Twilight-qwq/Intelligent-tracking-car-based-on-STM32-and-K210/Visual/config.py

# -*- coding: utf-8 -*-
"""
============================================================
 config.py  ·  所有可以调的东西都在这一个文件里
------------------------------------------------------------
 这个文件里没有任何逻辑，全是数字和开关。调参只改这里。
============================================================
"""

# ------------------------------------------------------------
# 一、摄像头怎么装的（上车前必须量准）
# ------------------------------------------------------------
CAM_H_CM = 20.0             # 镜头离地高度，单位厘米
CAM_PITCH_DEG = 30.0        # 镜头往下低头多少度
HFOV_DEG = 90.0             # 镜头水平视场角

ROW_TWEAK = 0               # 整组扫描行上/下平移几行（应急微调）

N_SCAN = 5                  # 用几行扫描
GAP_MIN = 22                # 最远那行：黑线至少要占这么多像素
GAP_MAX = 62                # 最近那行：再近车道就撑出画面了


# ------------------------------------------------------------
# 二、找线
# ------------------------------------------------------------
RUN_MIN = 3                 # 连续几个黑点才算一条线（滤噪点）
RUN_MAX = 26                # 超过这么宽就不是"线"，是糊成一片
GAP_TOL = 14                # 实测间距和理论值差多少还算数
SIDE_DEAD = 12              # 只剩一根线时，它离画面中心多近就不敢判左右
CONTRAST_MIN = 70           # 这一行最亮减最暗至少多少才认
BLACK_RATIO = 0.40          # 阈值 = 最暗 + (最亮 - 最暗) * 0.40

X_MIN = 4                   # 每行从左扫到哪
X_MAX = 155                 # 每行扫到右到哪


# ------------------------------------------------------------
# 三、判断
# ------------------------------------------------------------
CALIB_OFFSET = 0            # 车摆正时读出多少就填多少
ERROR_GAIN = 1.0            # 误差再放大或缩小，一般不用改

CURV_T1 = 10                # 远处偏差 > 10 像素 -> 状态 1
CURV_T2 = 22                # 远处偏差 > 22 像素 -> 状态 2

CORNER_BIAS = 40            # 确认前面是右弯时，把误差顶到多少
CORNER_TRIGGER = 8          # 但只有当前误差还小于这个数才算"刚进弯"
CORNER_X = 50               # 外侧线在这个位置左边 = 前面是右弯

SMOOTH_SHIFT = 0            # 0 = 不滤波；画面抖就改 1 或 2

LOST_KEEP = 10              # 丢线 10 帧以内：照上次的结果继续发
LOST_ERR_HOLD = 1           # 超过 10 帧：1=沿用上次误差，0=发 0

FINISH_ENABLE = False       # 终点线检测，默认关
FINISH_ROWS = 4             # 几行整行变黑才算横线
FINISH_FRAMES = 3           # 连续几帧才认


# ------------------------------------------------------------
# 四、串口
# ------------------------------------------------------------
BAUD = 115200               # 必须和 STM32 一致
PIN_TX = 24                 # K210 IO24 -> STM32 PA10
PIN_RX = 25                 # 用不到，但 fpioa 要先占住


# ------------------------------------------------------------
# 五、调试
# ------------------------------------------------------------
VFLIP = False               # 画面上下颠倒改 True
HMIRROR = False             # 画面左右镜像改 True（误差自动取反）
DEBUG_DRAW = True           # 画面上画标记
PRINT_EVERY = 30            # 每 30 帧打印一行
PRINT_TABLE = True          # 启动时把算出来的表打出来
