Twilight-qwq/Intelligent-tracking-car-based-on-STM32-and-K210/Control/HardwareLayer/ReceiverK210.c

#include "stm32f10x.h"
#include "ReceiverK210.h"
#include "Protocol.h"
void k210rcv_Init(void)
{
	RCC_APB2PeriphClockCmd(RCC_APB2Periph_GPIOA,ENABLE);
	GPIO_InitTypeDef GPIO_InitStruct;
	GPIO_InitStruct.GPIO_Mode=GPIO_Mode_IPU;
	GPIO_InitStruct.GPIO_Pin=GPIO_Pin_10;
	GPIO_InitStruct.GPIO_Speed=GPIO_Speed_50MHz;
	GPIO_Init(GPIOA,&GPIO_InitStruct);

	RCC_APB2PeriphClockCmd(RCC_APB2Periph_USART1,ENABLE);
	USART_InitTypeDef USART_Initstruct;
	USART_Initstruct.USART_BaudRate=115200;
	USART_Initstruct.USART_HardwareFlowControl=USART_HardwareFlowControl_None;
	USART_Initstruct.USART_Mode=USART_Mode_Rx;
	USART_Initstruct.USART_Parity=USART_Parity_No;
	USART_Initstruct.USART_StopBits=USART_StopBits_1;
	USART_Initstruct.USART_WordLength=USART_WordLength_8b;
	USART_Init(USART1,&USART_Initstruct);
	USART_ITConfig(USART1,USART_IT_RXNE,ENABLE);

	NVIC_InitTypeDef NVIC_InitStruct;
	NVIC_InitStruct.NVIC_IRQChannel=USART1_IRQn;
	NVIC_InitStruct.NVIC_IRQChannelCmd=ENABLE;
	NVIC_InitStruct.NVIC_IRQChannelPreemptionPriority=0;
	NVIC_InitStruct.NVIC_IRQChannelSubPriority=0;
	NVIC_Init(&NVIC_InitStruct);

	USART_Cmd(USART1,ENABLE);
}

void USART1_IRQHandler(void)
{
	if(USART_GetITStatus(USART1,USART_IT_RXNE)==SET)
	{
		uint8_t data = USART_ReceiveData(USART1);
		Protocol_VisionParse(data);
	}
}
