Twilight-qwq/Intelligent-tracking-car-based-on-STM32-and-K210/(commit log)

2026-11-07 feat: STM32F103 + K210 dual-core line-following vehicle (control, vision, specification)
    [引脚分配表.xlsx]
2026-11-07 feat(debug): switch debug stream to VOFA+ JustFloat binary frames
    - 24-byte frame: five little-endian IEEE-754 floats plus the 0x00 0x00 0x80 0x7F tail
    - channels: left target / left actual / right target / right actual / vision error
    - removes the printf and %.1f dependency on MicroLIB entirely
    - Debug_log now takes a debugdata_t pointer and runs unconditionally, so frames
    keep flowing while the vehicle is stopped
    [Service.c]
2026-11-07 fix(service): sample the encoder before reading it in the 5 ms velocity loop
    Encoder_GetDeltaLeft/Right return the delta produced by the previous
    Encoder_Update() call. Reading them before calling Encoder_Update() therefore
    handed the velocity PI a one-period-stale measurement, adding avoidable phase
    lag to the inner loop.
    Also dropped an outdated comment block in Debug.c that no longer described the
    JustFloat frame layout.
    [Service.c]
2026-11-08 feat(protocol): struct-based parsers, Bluetooth tuning channel, runtime-tunable gains
    - protocol layer exposes VisionData_t / Protocol_GetVision and BtCommand_t /
    Protocol_BtParse instead of raw globals; ISR and caller contexts are separated
    by a PRIMASK save-restore critical section
    - USART2 gains a 32-byte RX ring buffer so the Bluetooth tuning path no longer
    blocks the main loop
    - tuning frames pass two validation layers: a NaN/Inf gate followed by
    per-parameter min/max limits
    - base speeds and PID gains are runtime variables, tunable from a phone without
    reflashing
    - the steering differential is clamped to the current base speed, keeping wheel
    targets non-negative and decoupl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
    [BlueTooth.c, ReceiverK210.c, Service.c, Service.h]
2026-11-08 chore(build): convert all sources to UTF-8 with BOM
    Every .c/.h under Control/ was GBK-encoded, which GitHub renders as mojibake
    because it decodes blobs as UTF-8. This converts them to UTF-8 with a BOM
    so both Keil and VS Code pick up the encoding without any manual step.
    - 21 files re-encoded; text was verified character-identical file by file.
    - Key.c was already UTF-8 but had no BOM, so six bytes were prepended.
    - Control/.vscode/settings.json now pins files.encoding to utf8 and turns
    files.autoGuessEncoding off, since that option silently overrode it.
    A full rebuild after the conversion produced an identical image
    (Code=8676 RO-data=272 RW-data=116 ZI-data=1172, 0 errors 0 warnings)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
    [BlueTooth.c, Encoder.c, Encoder.h, Key.c, Motor.c]
2026-11-08 feat(indicator): PC13 status LED driven by run state and vision health
    The board LED (PC13, active low) now reports what the car is doing, so the
    vehicle can be read from a distance without a terminal attached.
    IndicatorLED is a thin driver only: init, turn on, turn off, toggle.
    The policy lives in Service.c as Task_Indicate, next to the other Task_*
    handlers and running from the same 100 ms tick.
    stopped -> slow blink (toggle every 500 ms)
    running, link ok -> steady on
    vision link lost -> fast blink (toggle every 100 ms)
    The vision-loss threshold is 120 ms, matching the frame-loss guard in
    Task_FetchVisionData (4 x 30 ms). Indicator_Fault latches and is cleared
    only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
